craftykate/beer-temp/(commit log)

2018-08-04 add temp sensor image
2018-08-04 upload rgb led pic
2018-08-05 Update temp sensor code
2018-08-05 Update RGB LED section
