craftykate/beer-temp/images/breadboard_final.JPG

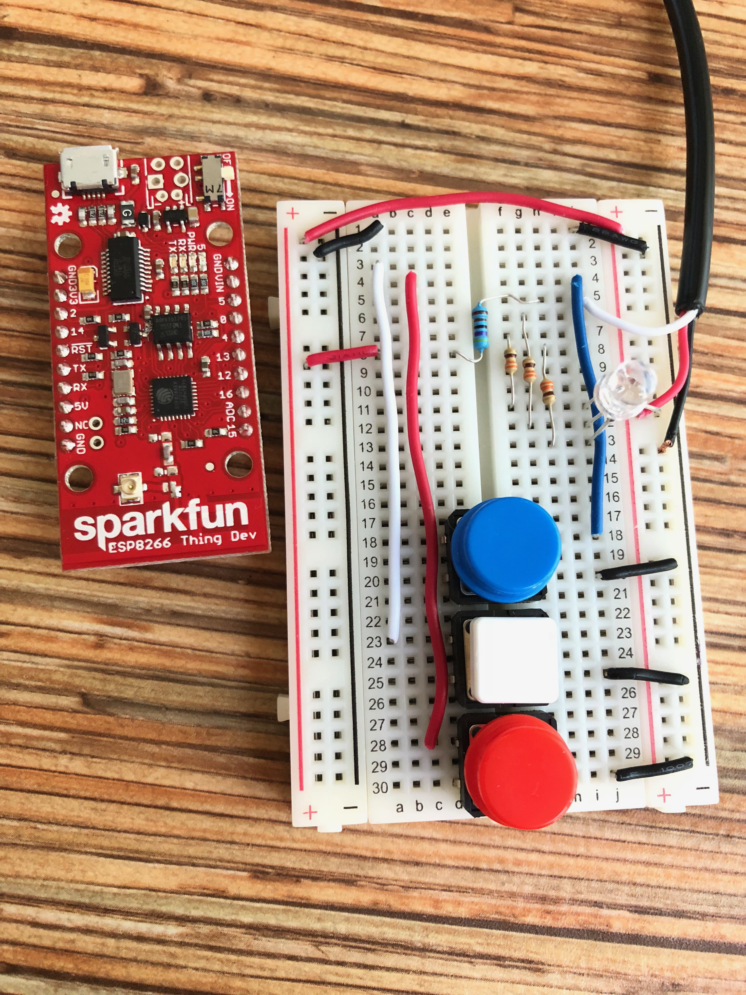
[picture p4: images/breadboard_final_1.JPG]
images/breadboard_final.JPG
