craftykate/beer-temp/images/breadboard_final_with_esp.JPG

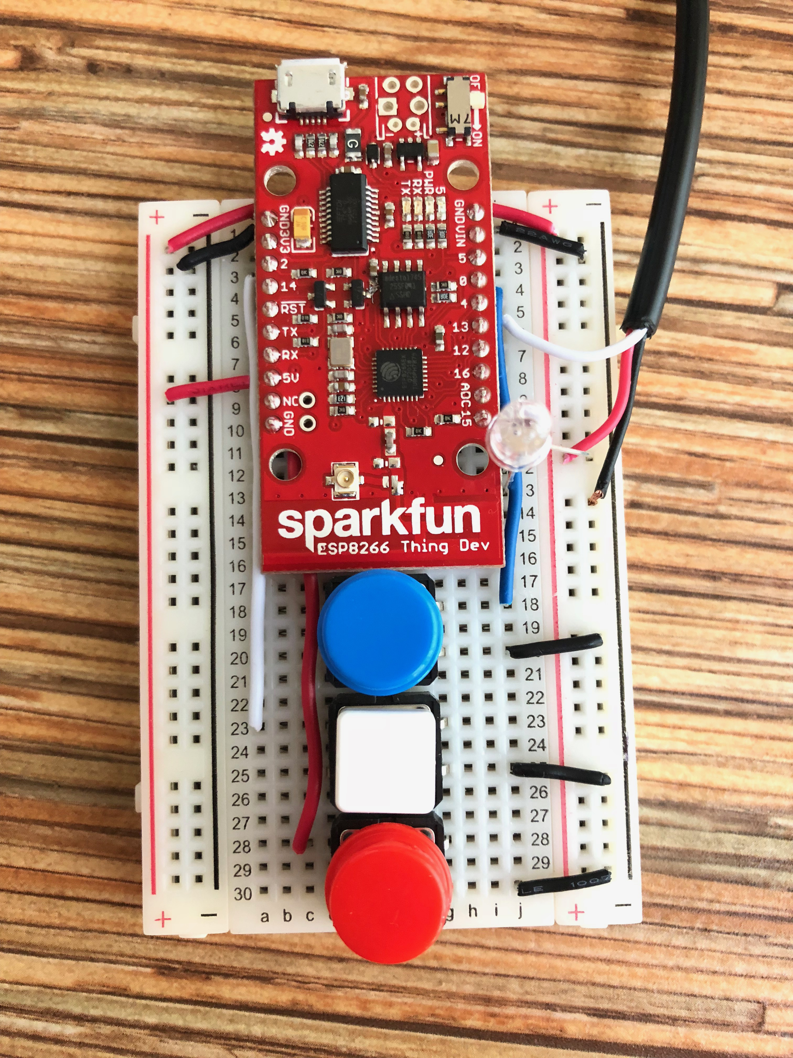
[picture p5: images/breadboard_final_with_esp_1.JPG]
images/breadboard_final_with_esp.JPG
